MuffinKing-jpeg/uAir/readme.md

# uAir

Small air monitor with OLED screen
