MuffinKing-jpeg/uAir/uAir.kicad_pcb

## KiCad design uAir.kicad_pcb (2026-06-02)

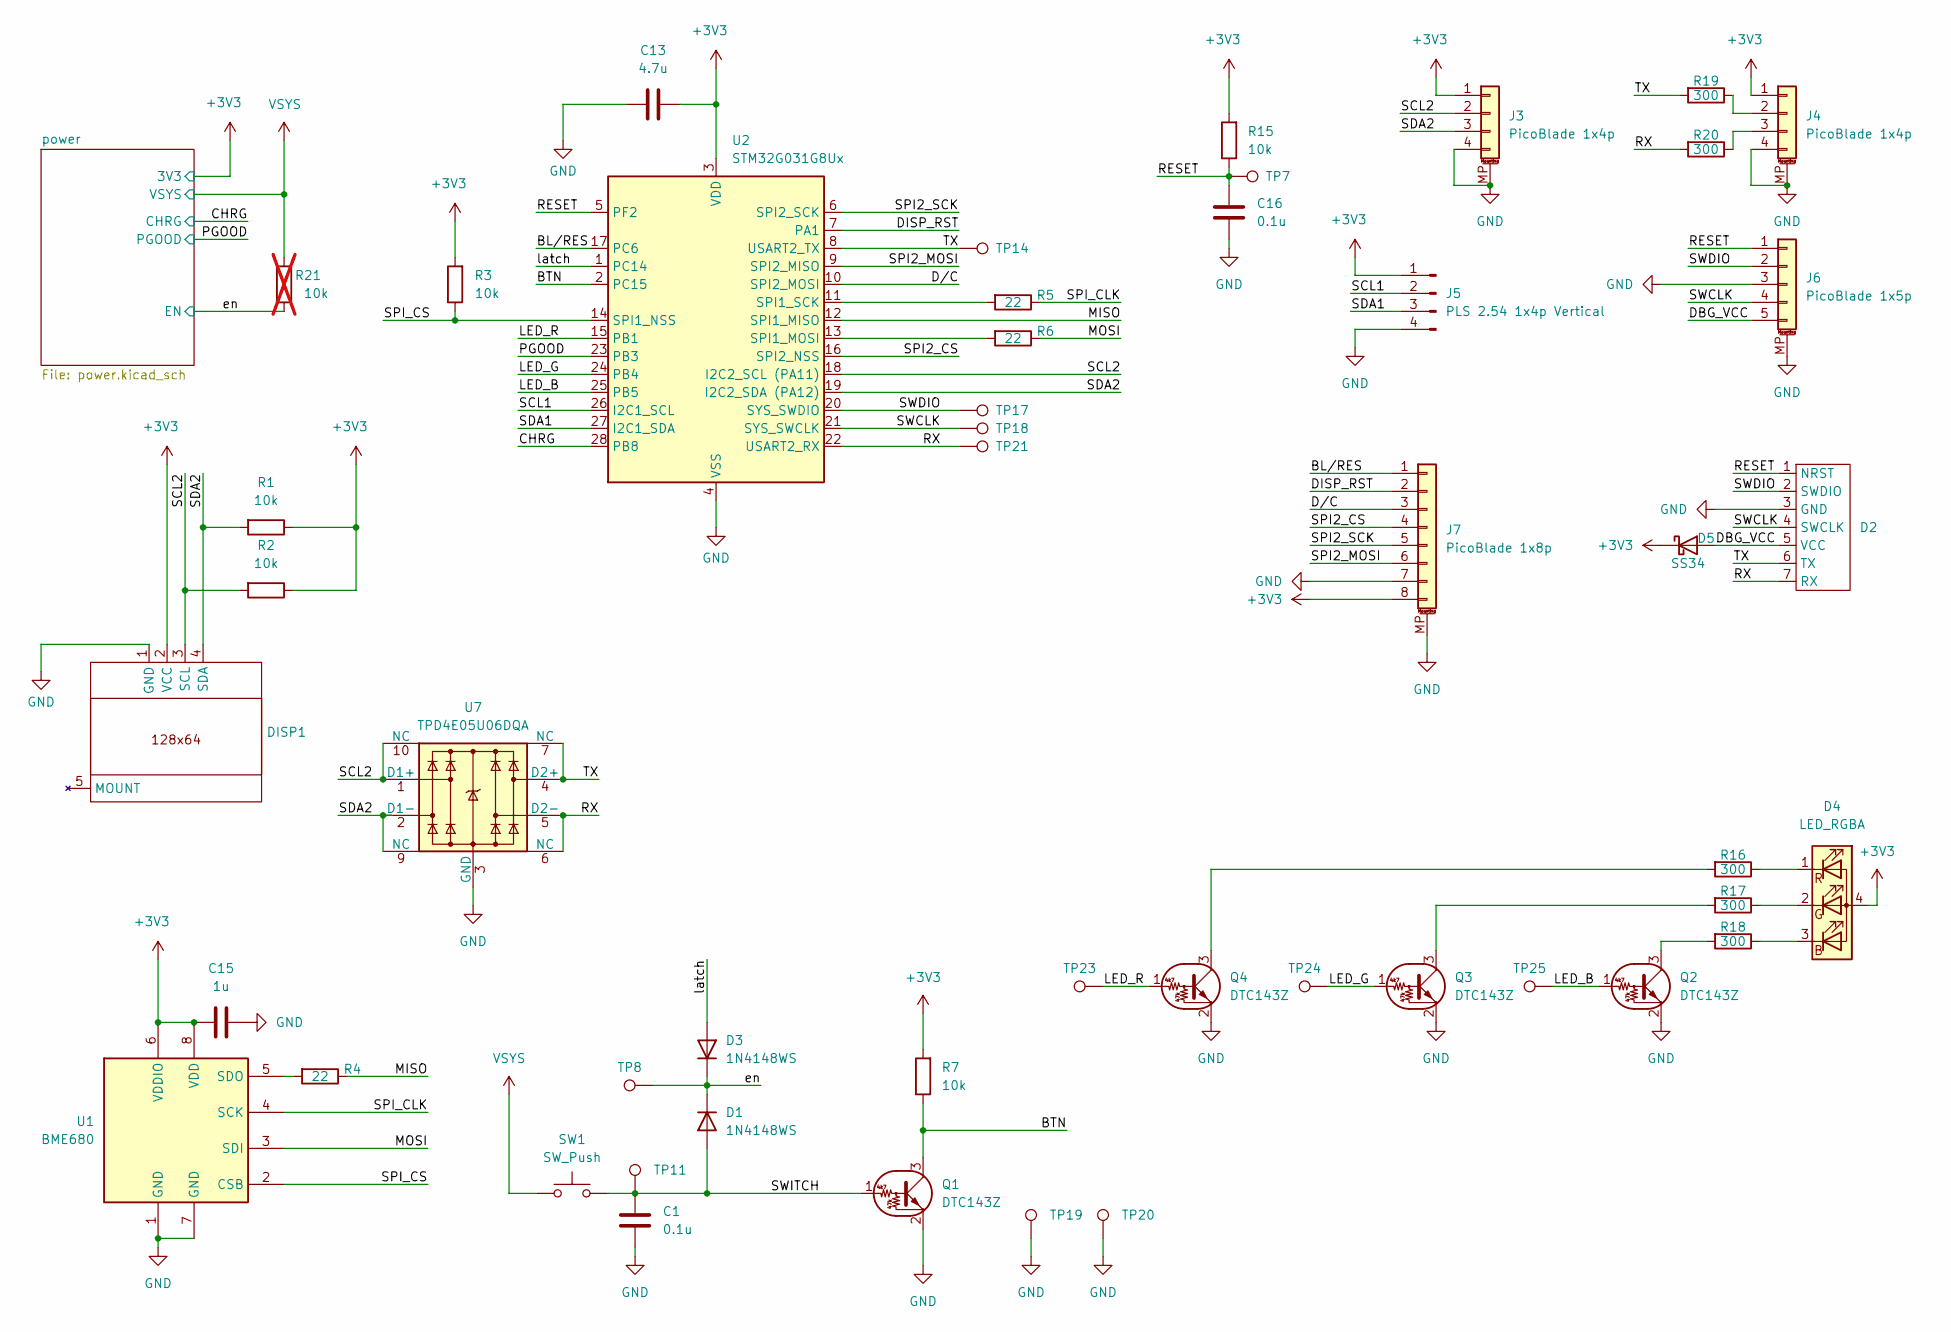
[picture p1: schematic uAir.kicad_sch]

Parts:
C1, C16: 0.1u; C_0402_1005Metric
C13: 4.7u; C_0603_1608Metric
C15: 1u; C_0603_1608Metric
D1, D3: 1N4148WS; D_SOD-323; LCSC C6423741
D2: DBG-CLIP-7_pad
D4: LED_RGBA; LED_LiteOn_LTST-C19HE1WT; LCSC C125110
D5: SS34; D_SMA
DISP1: OLED_Module_I2C_WeAct
J3, J4: PicoBlade 1x4p; Molex_PicoBlade_53261-0471_1x04-1MP_P1.25mm_Horizontal
J5: PLS 2.54 1x4p Vertical; PinHeader_1x04_P2.54mm_Vertical
J6: PicoBlade 1x5p; Molex_PicoBlade_53261-0571_1x05-1MP_P1.25mm_Horizontal
J7: PicoBlade 1x8p; Molex_PicoBlade_53261-0871_1x08-1MP_P1.25mm_Horizontal
Q1: DTC143Z; SOT-523; LCSC C2828442
Q2, Q3, Q4: DTC143Z; SC-59; LCSC C2828442
R1, R2, R3, R7, R15: 10k; R_0603_1608Metric
R4, R5, R6: 22; R_0603_1608Metric
R16, R17, R18, R19, R20: 300; R_0603_1608Metric
R21: 10k; R_0603_1608Metric; not fitted
SW1: SW_Push; SW_Kailh_Choc_V1V2_Led
TP7: nRESET; TestPoint_THTPad_D1.0mm_Drill0.5mm
TP8: EN; TestPoint_THTPad_D1.0mm_Drill0.5mm
TP11: SWITCH; TestPoint_Pad_D1.0mm
TP14: TX; TestPoint_THTPad_D1.0mm_Drill0.5mm
TP17: SWDIO; TestPoint_THTPad_D1.0mm_Drill0.5mm
TP18: SWCLK; TestPoint_THTPad_D1.0mm_Drill0.5mm
TP19, TP20: GND; TestPoint_THTPad_D1.0mm_Drill0.5mm
TP21: RX; TestPoint_THTPad_D1.0mm_Drill0.5mm
TP23: LED_R; TestPoint_THTPad_D1.0mm_Drill0.5mm
TP24: LED_G; TestPoint_THTPad_D1.0mm_Drill0.5mm
TP25: LED_B; TestPoint_THTPad_D1.0mm_Drill0.5mm
U1: BME680; Bosch_LGA-8_3x3mm_P0.8mm_ClockwisePinNumbering
U2: STM32G031G8Ux; QFN-28_4x4mm_P0.5mm
U7: TPD4E05U06DQA; USON-10_2.5x1.0mm_P0.5mm

Connections:
+3V3: C13.2, C15.1, D4.4 (A), D5.1 (K), DISP1.2 (VCC), J3.1, J4.1, J5.1, J7.8, R1.1, R2.1, R3.2, R7.2, R15.2, U1.6 (VDDIO), U1.8 (VDD), U2.3 (VDD); also elsewhere on the board
/BL/RES: J7.1, U2.17 (PC6)
/BTN: Q1.3 (C), R7.1, U2.2 (PC15)
/CHRG: U2.28 (PB8); also elsewhere on the board
/DBG_VCC: D2.5 (VCC), D5.2 (A), J6.5
/DISP_RST: J7.2, U2.7 (PA1)
/D/C: J7.3, U2.10 (SPI2_MOSI)
/LED_B: Q2.1 (B), TP25.1 (1_1), U2.25 (PB5)
/LED_G: Q3.1 (B), TP24.1 (1_1), U2.24 (PB4)
/LED_R: Q4.1 (B), TP23.1 (1_1), U2.15 (PB1)
/MISO: R4.1, U2.12 (SPI1_MISO)
/MOSI: R6.1, U1.3 (SDI)
/PGOOD: U2.23 (PB3); also elsewhere on the board
/RESET: C16.1, D2.1 (NRST), J6.1, R15.1, TP7.1 (1_1), U2.5 (PF2)
/RX: D2.7 (RX), R20.2, TP21.1 (1_1), U2.22 (USART2_RX), U7.5 (D2-), U7.6 (NC)
/SCL1: J5.2, U2.26 (I2C1_SCL)
/SCL2: DISP1.3 (SCL), J3.2, R2.2, U2.18 (I2C2_SCL (PA11)), U7.1 (D1+), U7.10 (NC)
/SDA1: J5.3, U2.27 (I2C1_SDA)
/SDA2: DISP1.4 (SDA), J3.3, R1.2, U2.19 (I2C2_SDA (PA12)), U7.2 (D1-), U7.9 (NC)
/SPI2_CS: J7.4, U2.16 (SPI2_NSS)
/SPI2_MOSI: J7.6, U2.9 (SPI2_MISO)
/SPI2_SCK: J7.5, U2.6 (SPI2_SCK)
/SPI_CLK: R5.1, U1.4 (SCK)
/SPI_CS: R3.1, U1.2 (CSB), U2.14 (SPI1_NSS)
/SWCLK: D2.4 (SWCLK), J6.4, TP18.1 (1_1), U2.21 (SYS_SWCLK)
/SWDIO: D2.2 (SWDIO), J6.2, TP17.1 (1_1), U2.20 (SYS_SWDIO)
/SWITCH: C1.1, D1.2 (A), Q1.1 (B), SW1.2, TP11.1 (1_1)
/TX: D2.6 (TX), R19.2, TP14.1 (1_1), U2.8 (USART2_TX), U7.4 (D2+), U7.7 (NC)
/en: D1.1 (K), D3.1 (K), R21.1, TP8.1 (1_1); also elsewhere on the board
/latch: D3.2 (A), U2.1 (PC14)
GND: C1.2, C13.1, C15.2, C16.2, D2.3 (GND), DISP1.1 (GND), J3.4, J3.MP (MountPin), J4.4, J4.MP (MountPin), J5.4, J6.3, J6.MP (MountPin), J7.7, J7.MP (MountPin), Q1.2 (E), Q2.2 (E), Q3.2 (E), Q4.2 (E), TP19.1 (1_1), TP20.1 (1_1), U1.1 (GND), U1.7 (GND), U2.4 (VSS), U7.3 (GND), U7.8 (GND); also elsewhere on the board
unnamed: D4.3 (BK), R18.1
unnamed: D4.2 (GK), R17.1
unnamed: D4.1 (RK), R16.1
unnamed: J4.2, R19.1
unnamed: J4.3, R20.1
unnamed: Q2.3 (C), R18.2
unnamed: Q3.3 (C), R17.2
unnamed: Q4.3 (C), R16.2
unnamed: R4.2, U1.5 (SDO)
unnamed: R5.2, U2.11 (SPI1_SCK)
unnamed: R6.2, U2.13 (SPI1_MOSI)
VSYS: R21.2, SW1.1; also elsewhere on the board

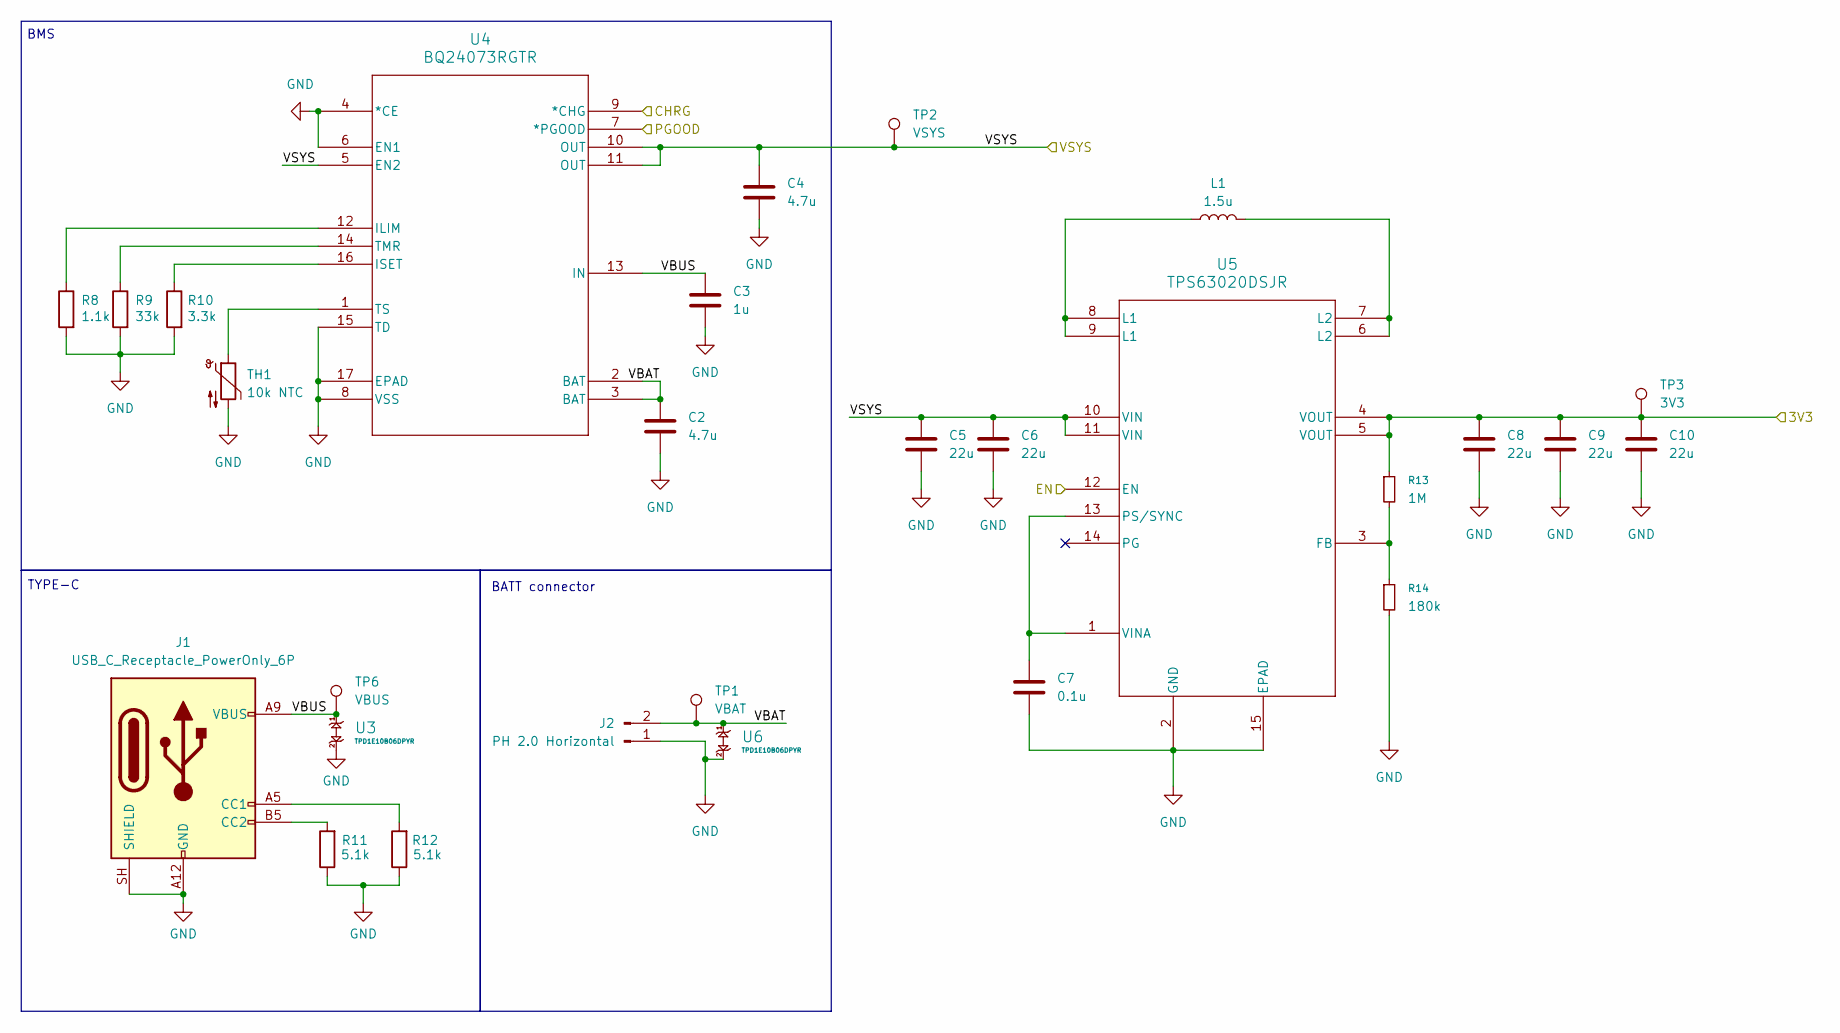
[picture p2: schematic power.kicad_sch]

Parts:
C2, C4: 4.7u; C_0603_1608Metric
C3: 1u; C_0603_1608Metric
C5, C6, C8, C9, C10: 22u; C_0805_2012Metric
C7: 0.1u; C_0402_1005Metric
J1: USB_C_Receptacle_PowerOnly_6P; USB_C_Receptacle_GCT_USB4125-xx-x-0190_6P_TopMnt_Horizontal
J2: PH 2.0 Horizontal; JST_PH_S2B-PH-K_1x02_P2.00mm_Horizontal
L1: 1.5u; L_1210_3225Metric
R8: 1.1k; R_0603_1608Metric
R9: 33k; R_0603_1608Metric
R10: 3.3k; R_0603_1608Metric
R11, R12: 5.1k; R_0603_1608Metric
R13: 1M; R_0402_1005Metric
R14: 180k; R_0402_1005Metric
TH1: 10k NTC; R_0402_1005Metric
TP1: VBAT; TestPoint_Pad_D1.0mm
TP2: VSYS; TestPoint_Pad_D1.0mm
TP3: 3V3; TestPoint_Pad_D1.0mm
TP6: VBUS; TestPoint_Pad_D1.0mm
U3, U6: TPD1E10B06DPYR; X1SON-2_L1.0-W0.6-P0.65-BI; LCSC C48260
U4: BQ24073RGTR; RGT16; LCSC C15220
U5: TPS63020DSJR; DSJ14_2P85X1P58; LCSC C15483

Connections:
+3V3: C8.1, C9.1, C10.1, R13.1, TP3.1 (1_1), U5.4 (VOUT), U5.5 (VOUT); also elsewhere on the board
/CHRG: U4.9 (*CHG); also elsewhere on the board
/PGOOD: U4.7 (*PGOOD); also elsewhere on the board
/en: U5.12 (EN); also elsewhere on the board
/power/VBAT: C2.1, J2.2, TP1.1 (1_1), U4.2 (BAT), U4.3 (BAT), U6.1
/power/VBUS: C3.1, J1.A9 (VBUS), J1.B9 (VBUS), TP6.1 (1_1), U3.1, U4.13 (IN)
GND: C2.2, C3.2, C4.2, C5.2, C6.2, C7.2, C8.2, C9.2, C10.2, J1.A12 (GND), J1.B12 (GND), J1.SH (SHIELD), J2.1, R8.2, R9.2, R10.2, R11.1, R12.1, R14.2, TH1.2, U3.2, U4.4 (*CE), U4.6 (EN1), U4.8 (VSS), U4.15 (TD), U4.17 (EPAD), U5.2 (GND), U5.15 (EPAD), U6.2; also elsewhere on the board
unnamed: J1.A5 (CC1), R12.2
unnamed: J1.B5 (CC2), R11.2
unnamed: L1.1, U5.8 (L1), U5.9 (L1)
unnamed: L1.2, U5.6 (L2), U5.7 (L2)
unnamed: R8.1, U4.12 (ILIM)
unnamed: R10.1, U4.16 (ISET)
unnamed: R9.1, U4.14 (TMR)
unnamed: TH1.1, U4.1 (TS)
unnamed: R13.2, R14.1, U5.3 (FB)
unnamed: C7.1, U5.1 (VINA), U5.13 (PS/SYNC)
VSYS: C4.1, C5.1, C6.1, TP2.1 (1_1), U4.5 (EN2), U4.10 (OUT), U4.11 (OUT), U5.10 (VIN), U5.11 (VIN); also elsewhere on the board

Notes on the sheet:
BATT connector
BMS
TYPE-C

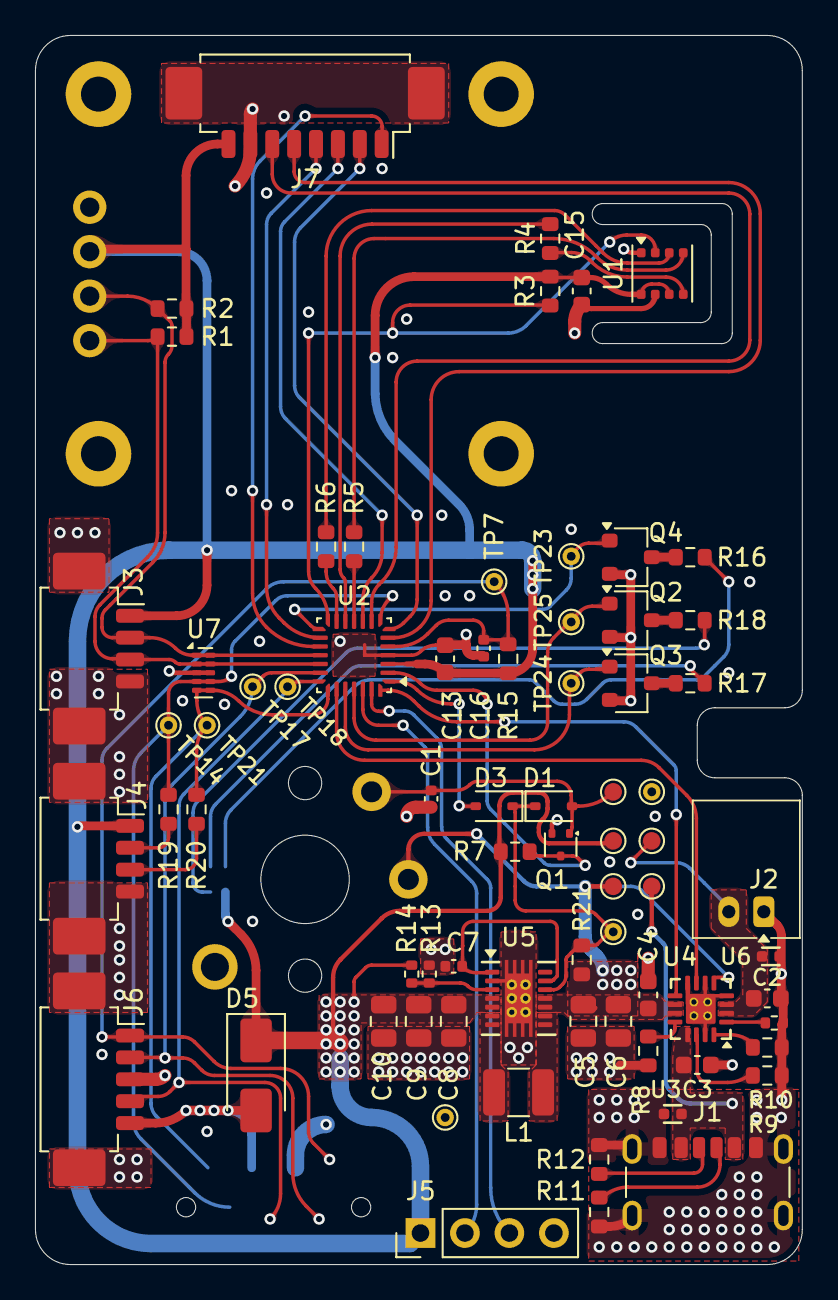
[picture p3: board uAir.kicad_pcb from above]

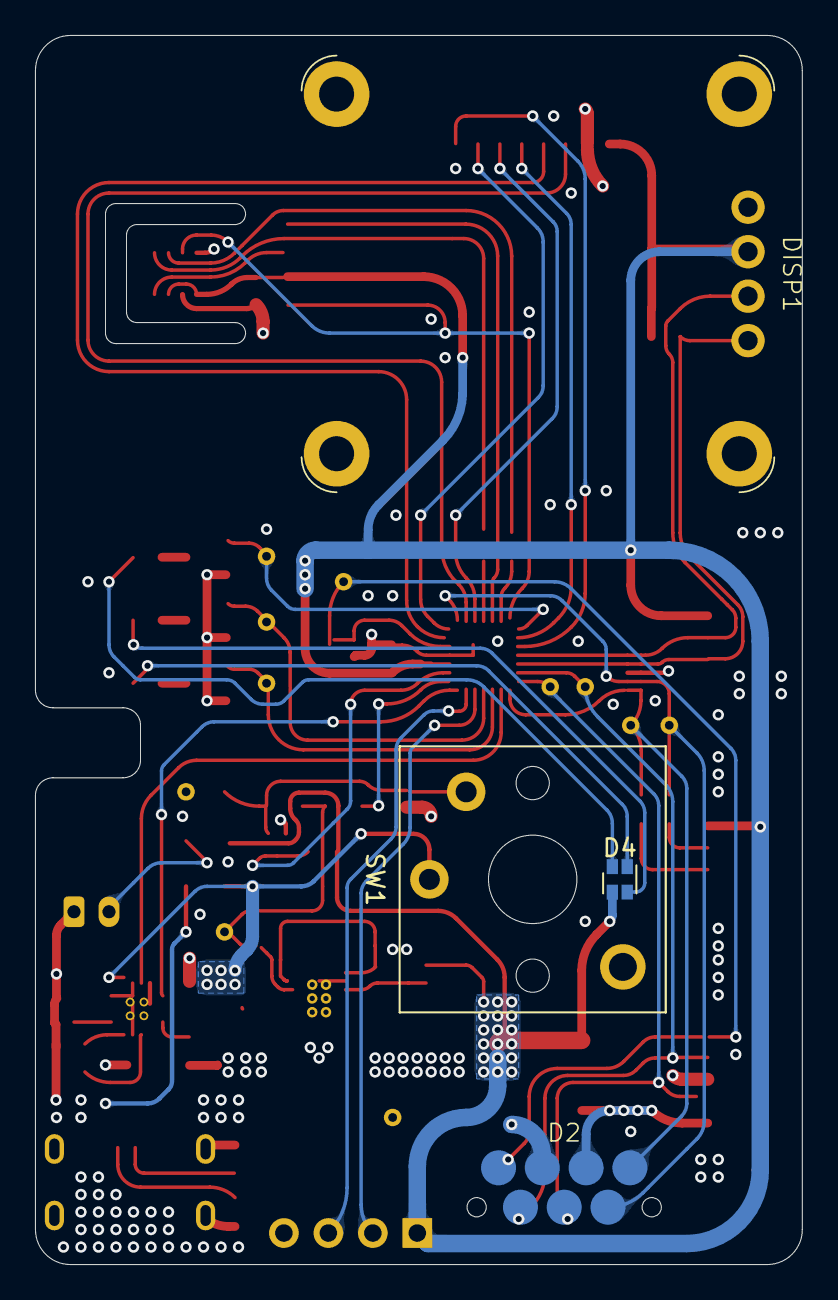
[picture p4: board uAir.kicad_pcb from below]

Board: 4 copper layers, 43.8 x 70.2 mm, 77 parts (4 on the bottom side), 55 nets.
