MuffinKing-jpeg/uAir/uAir.ioc

Mcu.UserName=STM32G031G8Ux
PA0.Signal=SPI2_SCK
PA1.GPIO_Label=DISP_RST
PA1.Signal=GPIO_Output
PA13.Signal=SYS_SWDIO
PA14-BOOT0.Signal=SYS_SWCLK
PA15.Signal=USART2_RX
PA2.Signal=USART2_TX
PA4.Signal=SPI2_MOSI
PA5.Signal=SPI1_SCK
PA6.Signal=SPI1_MISO
PA7.Signal=SPI1_MOSI
PA8.Signal=SPI2_NSS
PB0.Signal=SPI1_NSS
PB1.Signal=S_TIM3_CH4
PB4.Signal=S_TIM3_CH1
PB5.Signal=S_TIM3_CH2
PB6.Signal=I2C1_SCL
PB7.Signal=I2C1_SDA
