MuffinKing-jpeg/uAir/(commit log)

2026-05-02 Init project
    [power.kicad_sch, uAir.kicad_pcb, uAir.kicad_sch]
2026-05-23 PCB WIP
    [power.kicad_sch, uAir.kicad_pcb, uAir.kicad_sch]
2026-06-02 Finished PCB
    [uAir.kicad_pcb]
